sunxiang9013-cell/cat-home/猫窝/README.md

# 猫窝控制程序

本目录保留当前主控、副板源码与配套固件、手机 Web 源码、开发测试及说明文件。整理日期：2026-11-03。

| 目录 | 内容 |
| --- | --- |
| [主控板源码](主控板源码/CatCameraControl/) | ESP32-S3：网页、摄像头、三路舵机、AHT20、两路灯带、配网与设备发现 |
| [主控板固件](主控板固件/) | 主控四个烧录 BIN |
| [副板源码](副板源码/CatCameraRemote/) | ESP32-CAM / OV2640：二号摄像头、配网与设备发现，无 OTA |
| [副板固件](副板固件/) | 副板四个烧录 BIN，与主控不可混用 |
| [Web源码](Web源码/) | 手机界面、静态预览、网页打包及测试 |
| [说明文档](说明文档/) | 接线、编译烧录、网络、摄像头及固件校验 |

## 当前版本与入口

主控 `cat-home-pair-2`，副板 `cat-camera-remote-pair-2`。二号预览及保存照片旋转 180°；两摄像头切换播放，二号地址自动发现。Wi-Fi 页面只保留两台一起连接。

最近一次实测两板均连接 **Allensun**，主界面为 http://192.168.0.3/，副板为 192.168.0.4；这些是 DHCP 当时分配的地址，不是固定地址。手机或电脑必须连接同一网络。也可尝试 http://cat-home.local/，是否可用取决于网络和客户端的 mDNS 支持。

## 使用和维护

- [使用与接线](说明文档/使用与接线.md)：外设 GPIO、电源与功能。
- [编译与烧录](说明文档/编译与烧录.md)：两板编译参数及四段烧录地址。
- [Web 开发](说明文档/Web开发.md)：本地预览、网页打包、测试。
- [Wi-Fi 设置](说明文档/Wi-Fi设置.md)：搜索、双板切网及地址恢复限制。
- [副板摄像头](说明文档/副板摄像头.md)：供电、下载底座及出图检查。
- [固件校验](说明文档/固件校验.md)：当前八个 BIN 的大小、SHA256 与验证范围。

## 已知问题

双板切网仍可能只成功一台：最近一次一号切到 Allensun，二号准备阶段超时取消；已单独恢复二号并验证出图，尚未修复切网可靠性。旧地址网页无法加载时，页内自动发现不能启动；可在路由器为两板保留 DHCP 地址。2313 上曾有丢包和画面超时；PWR 按键关机问题仍未完成诊断。

本次整理不改变设备程序逻辑、不重新烧录；保留已部署固件。删除早期 USB 摄像头桥接工具及其专用测试、移除串口依赖，保留有效的测试和编译工具。运行设备不需要电脑常开。
