sunxiang9013-cell/cat-home/猫窝/说明文档/固件校验.md

# 当前固件与 SHA256 校验

整理日期：2026-11-03。保留已部署主控 `cat-home-pair-2`、副板 `cat-camera-remote-pair-2`；本次仅整理开发工具与说明，八个固件 BIN 不变。

主控程序 1,117,490 字节、全局 63,460 字节；副板程序 1,105,993 字节、全局 62,016 字节。此前两板编译无警告，四段 USB 烧录及哈希校验通过。主控最新包含二号画面和保存照片旋转 180°，副板包含 HTTP 响应结束处理修正，无 OTA。

| 文件 | 字节数 | SHA256 |
| --- | ---: | --- |
| 副板固件/boot_app0.bin | 8192 | F94C5D786A7A8FAB06AC5D10E33BF37711A6697636DC037559EA19CC410A17F0 |
| 副板固件/CatCameraRemote.ino.bin | 1106144 | 2EB425F6A0F23E0215C1CE00CDAE65C763EB6C4170F9A1647B6811CC8CD3D1BB |
| 副板固件/CatCameraRemote.ino.bootloader.bin | 24992 | 427F96E10C620C4F062DAB15DA54FC45494D897E8397AE6F3AECC98C42D7E379 |
| 副板固件/CatCameraRemote.ino.partitions.bin | 3072 | AAAE2888C5A6A348004B5B436F47ABB25AE32E72D9003902955A998EDA723EDD |
| 主控板固件/boot_app0.bin | 8192 | F94C5D786A7A8FAB06AC5D10E33BF37711A6697636DC037559EA19CC410A17F0 |
| 主控板固件/CatCameraControl.ino.bin | 1117632 | B9AF2F7A58F6CD842D4EC50D5FF0D1CB997101DC318D8D60EEEAAA855DFD8EC0 |
| 主控板固件/CatCameraControl.ino.bootloader.bin | 19968 | 73BD425E380C709F6ABD83AA987CB51C042A9AA8DE44A37A9EDB22D53BCA08DD |
| 主控板固件/CatCameraControl.ino.partitions.bin | 3072 | 1D9CCA96DE0FE07AD7FC0648B9878DDECD9CE565E38B589AD20FEA698ED4C80C |

## 已验证范围

- 主控实际提供的 camera-view.js 与旋转版源码一致；四色图测试通过预览旋转、照片像素旋转及切回一号恢复方向检查。
- 网页离线测试覆盖双板身份检查、地址变化、Wi-Fi 搜索、提交响应丢失、画面回退及旧帧提示。
- Allensun 曾通过连续 30 次状态与 JPEG 检查，实际手机视口解码成功；2313 曾出图，但仍出现丢包。
- 最近一次双板切网：主控成功到 Allensun；副板同一任务停在准备阶段，最终 phase=cancelled、error=expired，仍在 2313。已单独恢复副板至 Allensun，主控 .3、副板 .4 互相发现；连续三次 JPEG 解码成功。该恢复未修改固件，切网可靠性仍待修复。

## 使用边界

IP 来自 DHCP，以上地址只是当时记录。自动发现不能保证在主页面无法加载、跨网段且 mDNS 不可用时恢复入口；双板网络切换也不是原子事务。短期出图检查不代表长期稳定性或发热、PWR 问题已解决。

## 本次整理校验

8 个 BIN 的 SHA256 与上表全部一致；9 个 Web 资源与主控 web_assets.h 解压内容逐字节一致；两板共用的 wifi_settings.h 和 device_discovery.h 一致。13 项基础测试通过，本地静态预览及全部网页资源返回正常，旧 USB 取图接口已移除。目录未保留 node_modules、build 或旧版本固件；本次未重新编译或烧录。
