sunxiang9013-cell/cat-home/(list of files, cad)

Other CAD files:
猫窝.3dm
