sunxiang9013-cell/cat-home/(commit log)

2026-11-03 Upload cat home source, firmware, model and documentation
    [猫窝.3dm]
2026-11-03 Add temporary server-side photo archive assembly
2026-11-03 Link verified photo backup and remove temporary assembly workflow
